tuxedotshirt/Hydroponic_System/Marketing/Stackable Tower v18 (1).gif

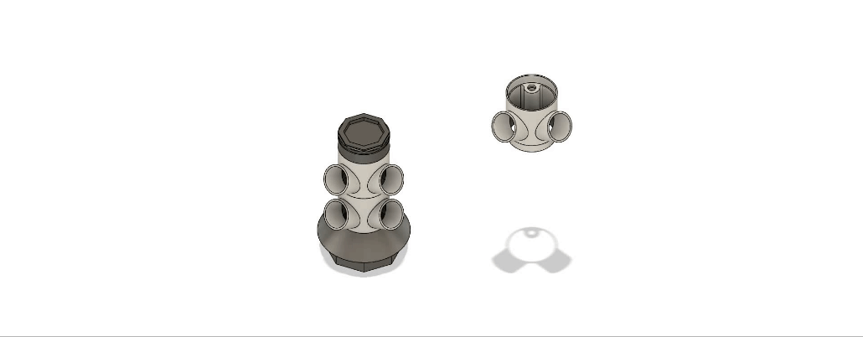
Marketing/Stackable Tower v18 (1).gif
