tuxedotshirt/Hydroponic_System/Marketing/Stackable Tower v18.gif

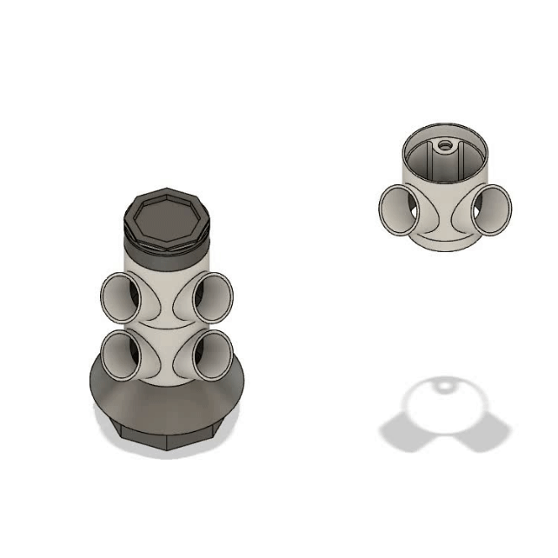
Marketing/Stackable Tower v18.gif
