tuxedotshirt/Hydroponic_System/Peristaltic Pump/Carrier.obj

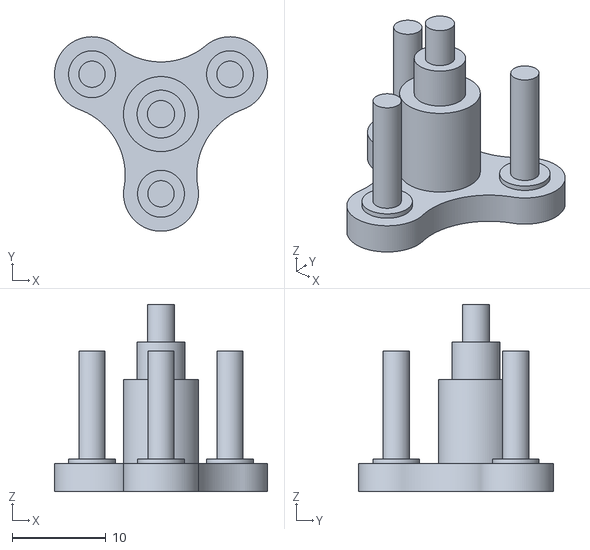
[picture p3: CAD file, 2023-01-23]
Peristaltic Pump/Carrier.obj
22.7 x 20.7 x 20.0
