tuxedotshirt/Hydroponic_System/Peristaltic Pump/Planetary Peristaltic Pump/Carrier.obj

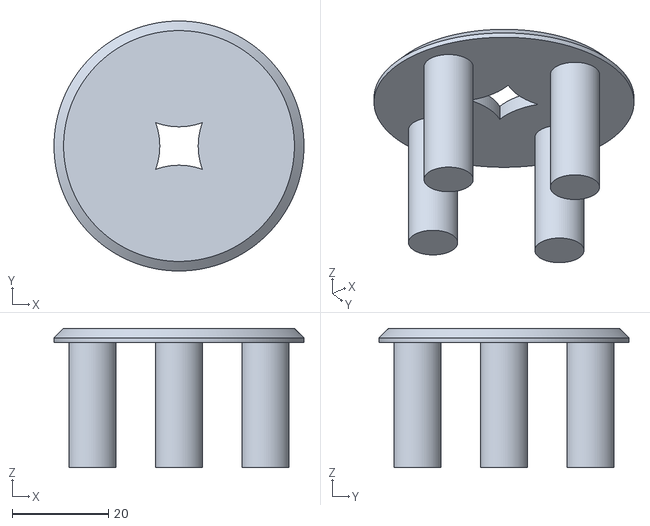
[picture p4: CAD file, 2023-04-20]
Peristaltic Pump/Planetary Peristaltic Pump/Carrier.obj
52.0 x 52.0 x 29.0
