tuxedotshirt/Hydroponic_System/Stackable Tower/Spacer.obj

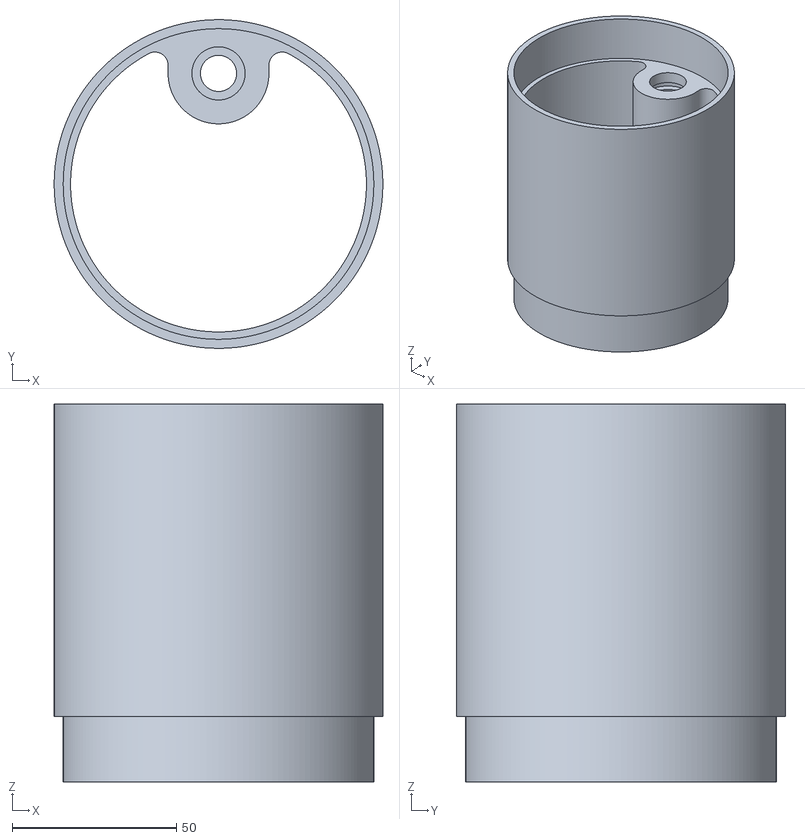
[picture p5: CAD file, 2023-11-28]
Stackable Tower/Spacer.obj
100.0 x 100.0 x 115.0
