tuxedotshirt/Hydroponic_System/Peristaltic Pump/Planetary Peristaltic Pump/Sun - 0.2mm Backlash (14 teeth).obj

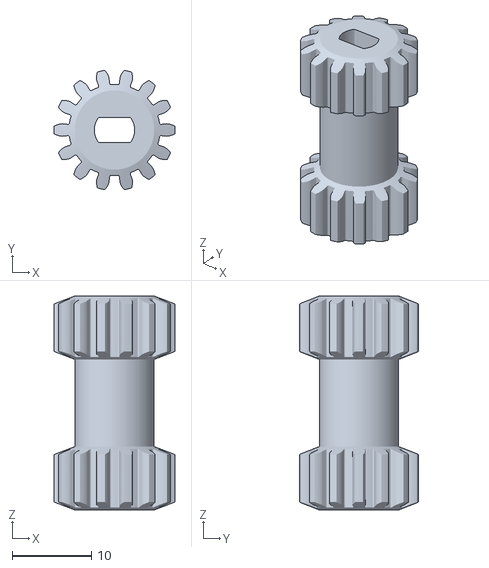
[picture p6: CAD file, 2023-04-20]
Peristaltic Pump/Planetary Peristaltic Pump/Sun - 0.2mm Backlash (14 teeth).obj
15.2 x 15.1 x 27.0
