tuxedotshirt/Hydroponic_System/Peristaltic Pump/Pump Body Cap.obj

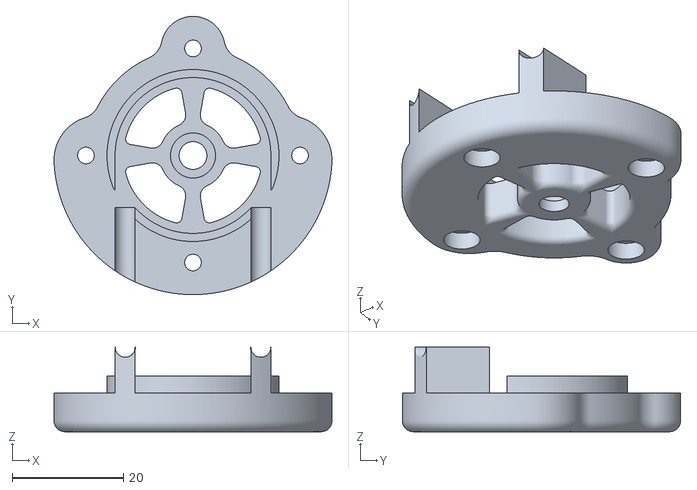
[picture p7: CAD file, 2023-01-23]
Peristaltic Pump/Pump Body Cap.obj
50.0 x 50.0 x 15.2
