tuxedotshirt/Hydroponic_System/Peristaltic Pump/Carrier Cap.obj

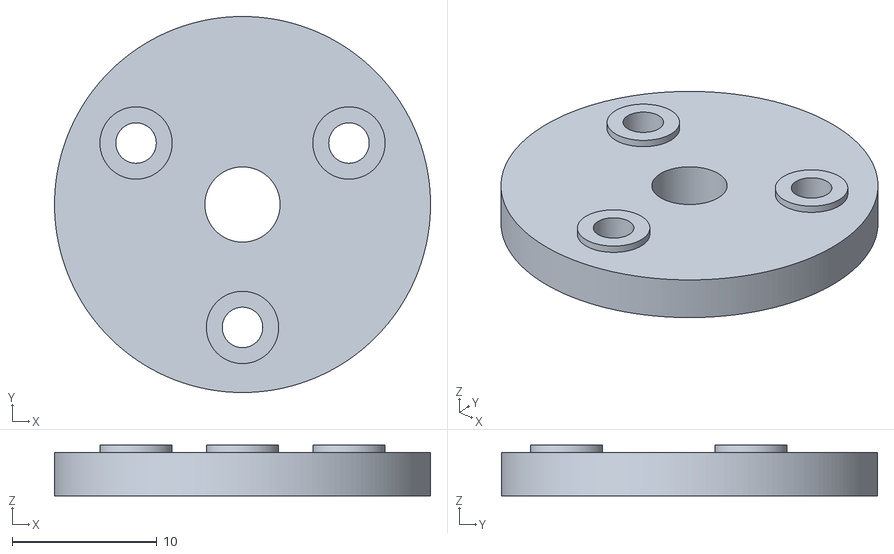
[picture p8: CAD file, 2023-01-23]
Peristaltic Pump/Carrier Cap.obj
26.0 x 26.0 x 3.50
