tuxedotshirt/Hydroponic_System/Peristaltic Pump/Planetary Peristaltic Pump/Sun.obj

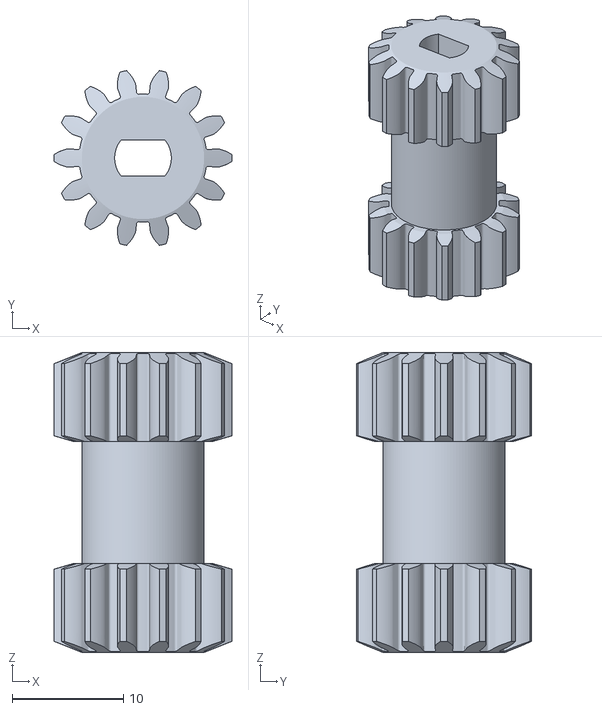
[picture p9: CAD file, 2023-04-20]
Peristaltic Pump/Planetary Peristaltic Pump/Sun.obj
16.0 x 15.7 x 27.0
