tuxedotshirt/Hydroponic_System/Peristaltic Pump/Planetary Peristaltic Pump/Planet.obj

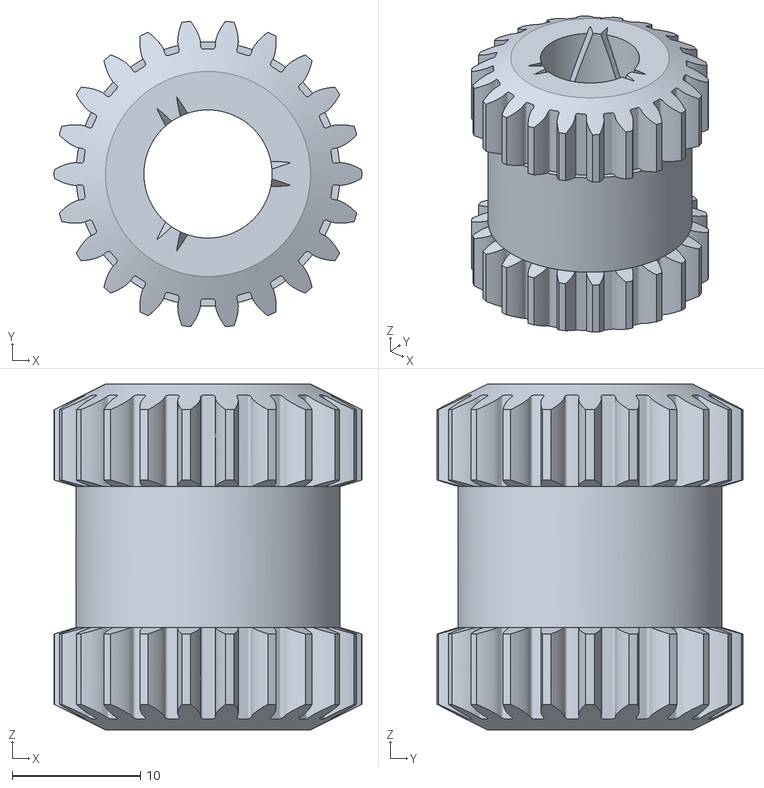
[picture p10: CAD file, 2023-04-20]
Peristaltic Pump/Planetary Peristaltic Pump/Planet.obj
24.0 x 23.8 x 27.0
