tuxedotshirt/Hydroponic_System/Stackable Tower/Base.obj

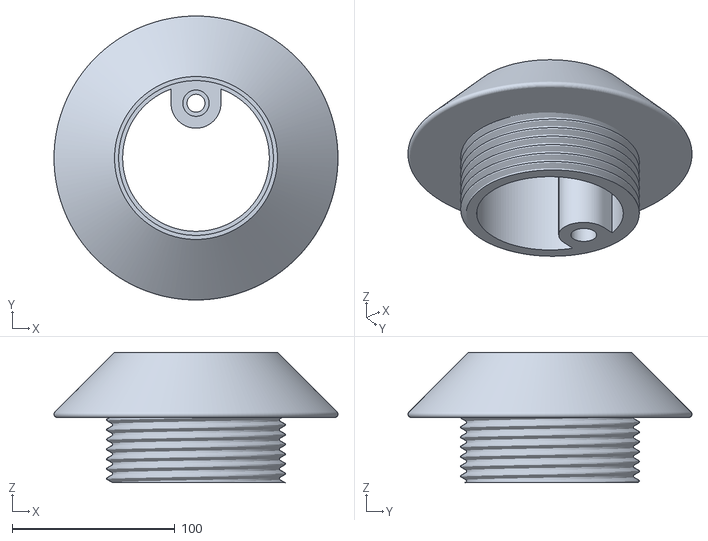
[picture p11: CAD file, 2023-11-12]
Stackable Tower/Base.obj
174.3 x 174.3 x 80.0
