tuxedotshirt/Hydroponic_System/Peristaltic Pump/Planetary Peristaltic Pump/RingTop.obj

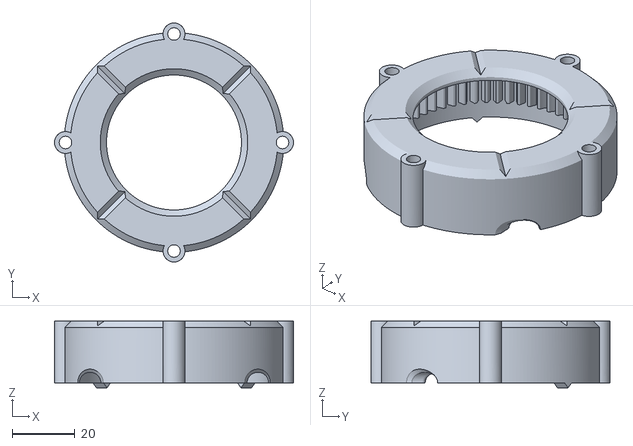
[picture p12: CAD file, 2023-04-20]
Peristaltic Pump/Planetary Peristaltic Pump/RingTop.obj
76.2 x 76.2 x 21.2
