tuxedotshirt/Hydroponic_System/Stackable Tower/Middle Module.obj

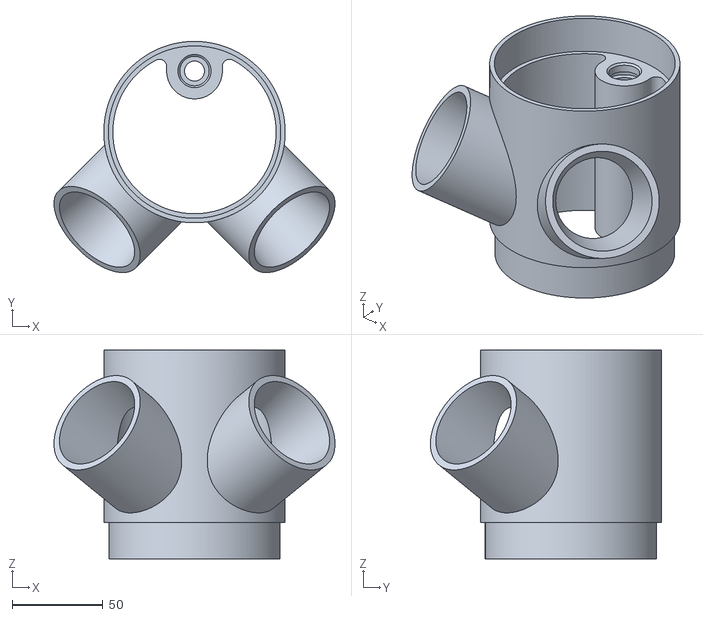
[picture p13: CAD file, 2023-11-12]
Stackable Tower/Middle Module.obj
154.9 x 127.5 x 115.0
