tuxedotshirt/Hydroponic_System/Stackable Tower/Shower Top Base.obj

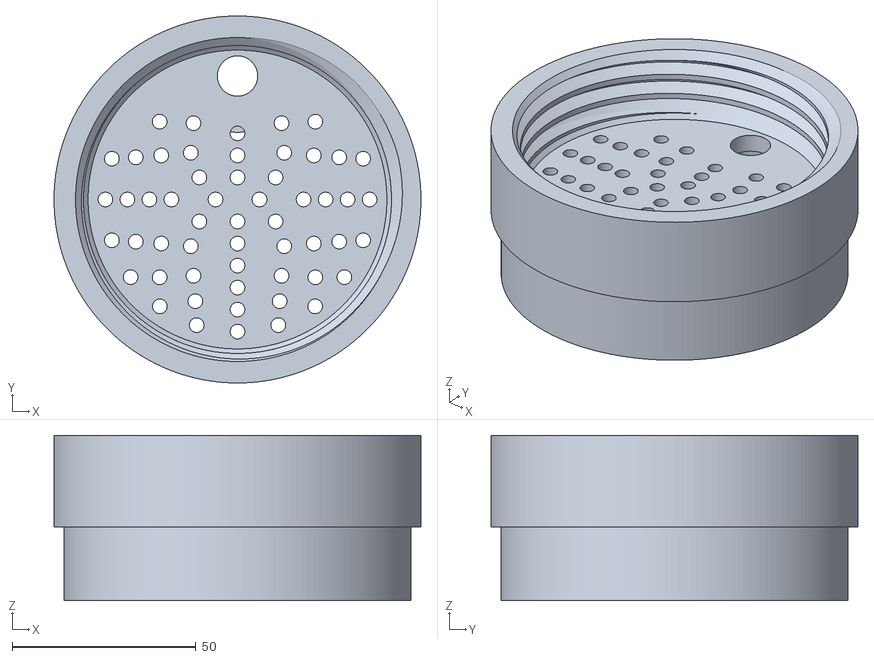
[picture p14: CAD file, 2023-11-12]
Stackable Tower/Shower Top Base.obj
100.0 x 100.0 x 45.0
