tuxedotshirt/Hydroponic_System/Stackable Tower/Screw Top.obj

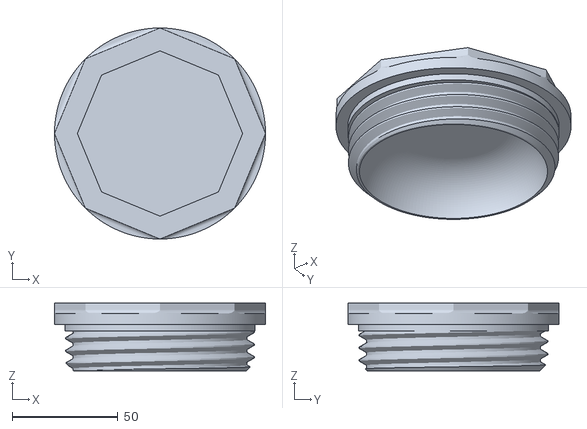
[picture p15: CAD file, 2023-11-12]
Stackable Tower/Screw Top.obj
100.0 x 100.0 x 32.2
