tuxedotshirt/Hydroponic_System/Stackable Tower/Nut.obj

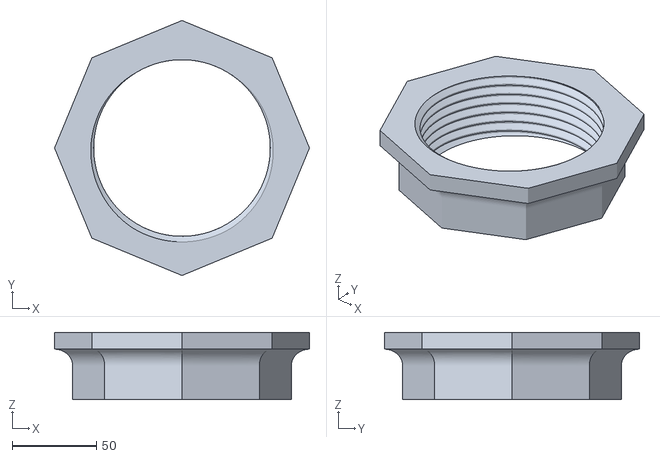
[picture p16: CAD file, 2023-11-12]
Stackable Tower/Nut.obj
151.5 x 151.5 x 40.0
