tuxedotshirt/Hydroponic_System/Hydro Documents/pH Probe/EZO-carrier-board-non-isolated.pdf

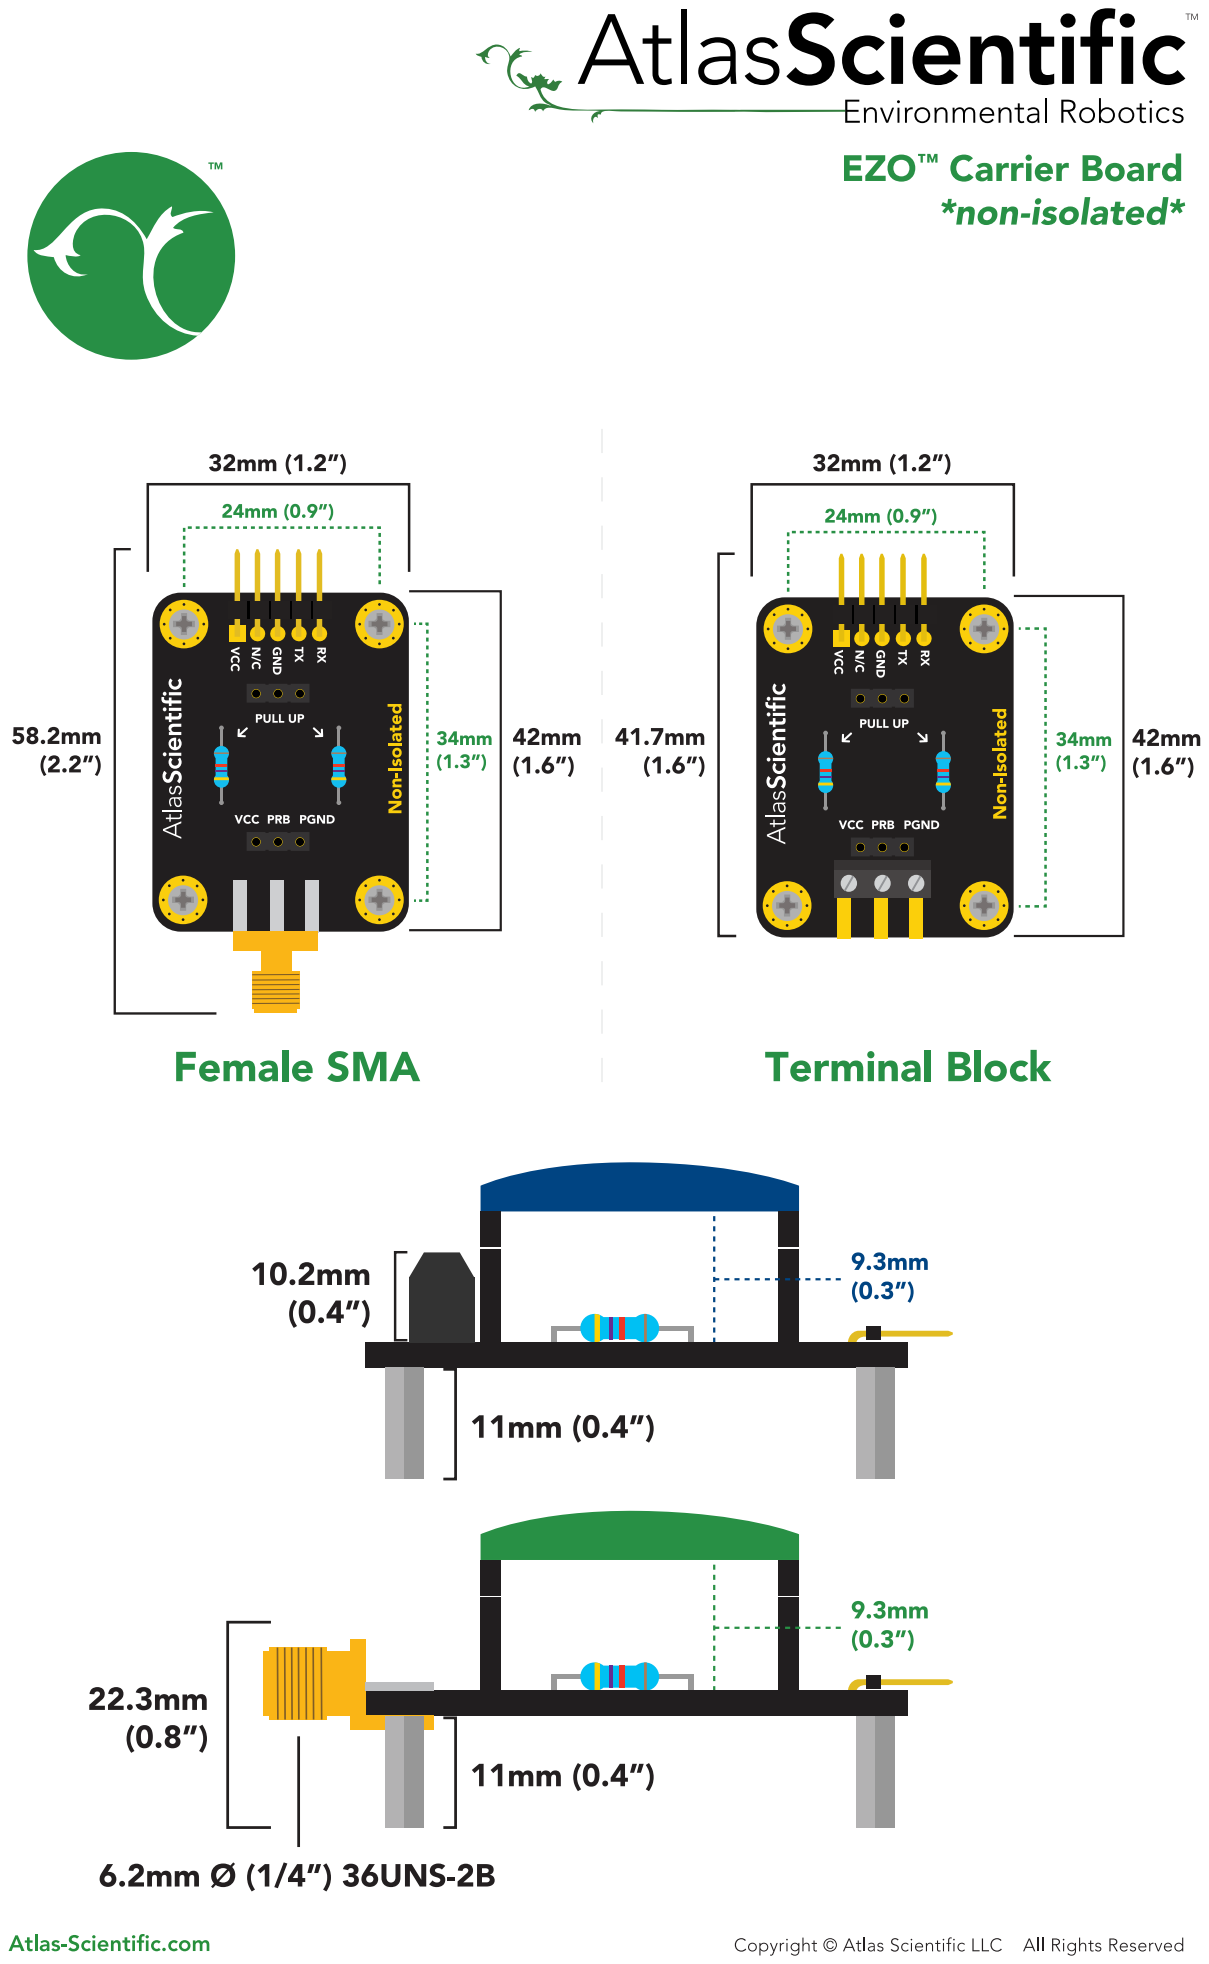
[picture p17: page 1]

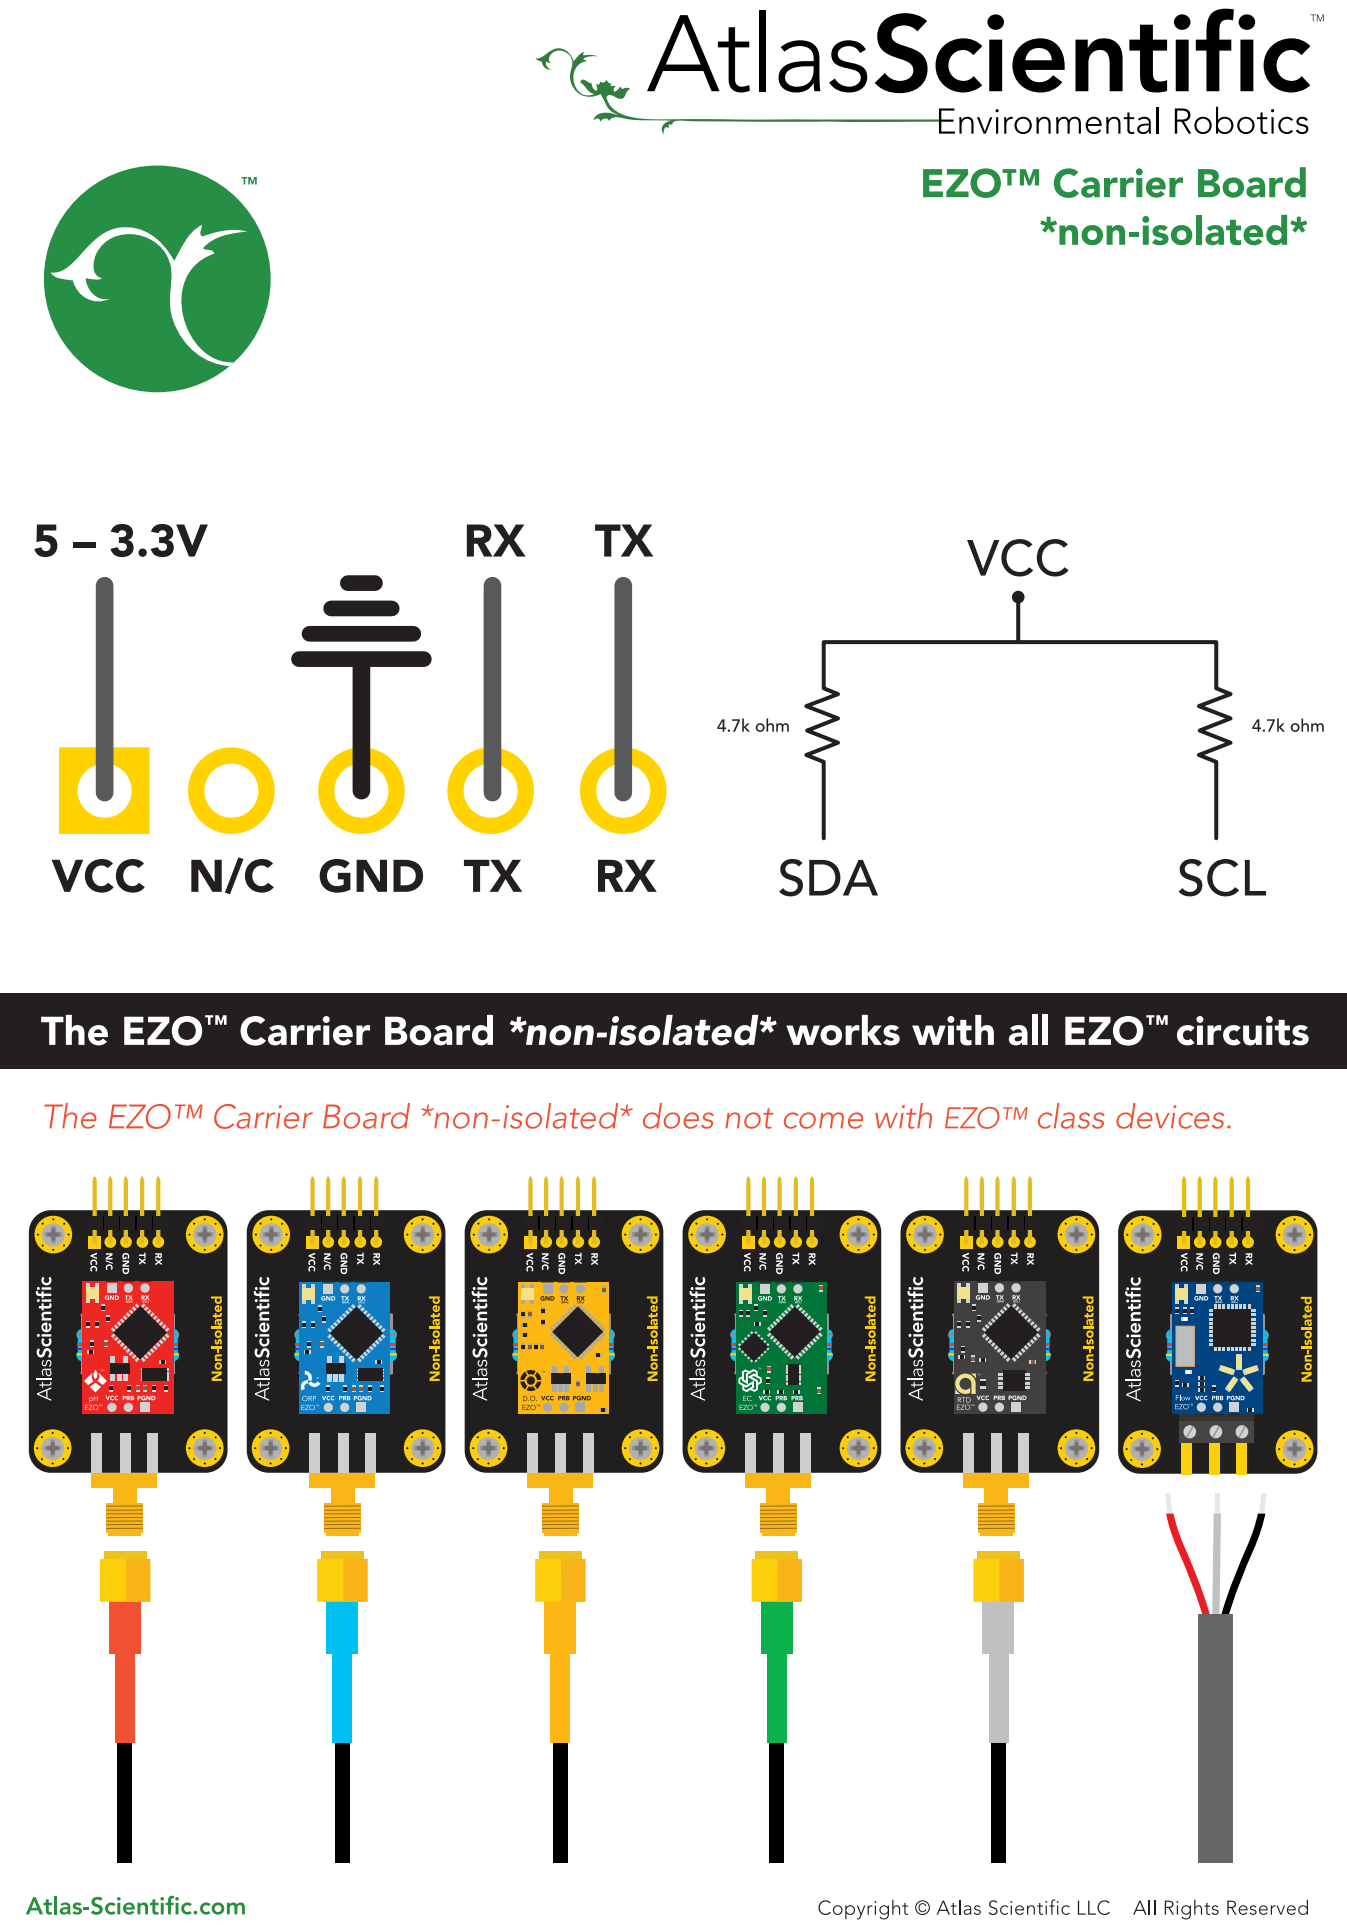
[picture p18: page 2]
