tuxedotshirt/Hydroponic_System/Hydro Documents/TDS Meter/plant_watering-V2.pdf

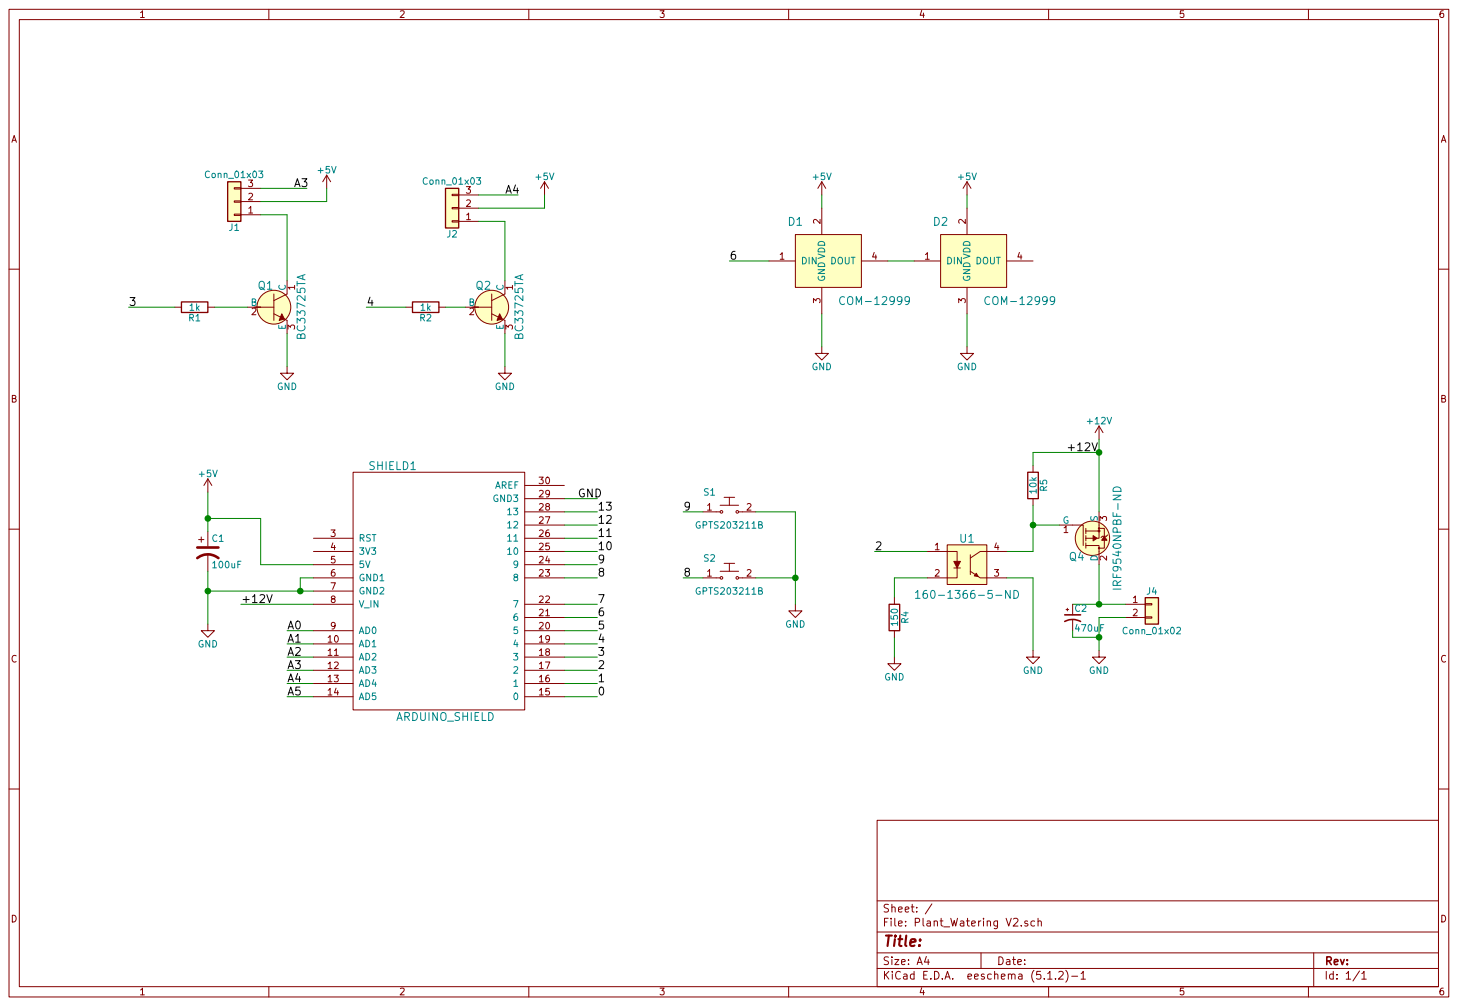
[picture p19: page 1]

3 DOUT 4 D1 COM-12999 DIN 1 VDD
