tuxedotshirt/Hydroponic_System/PCBs/Photo Light/Supplemental Light/Supplemental Light.kicad_pcb

## KiCad design PCBs/Photo Light/Supplemental Light/Supplemental Light.kicad_pcb (2023-12-05)

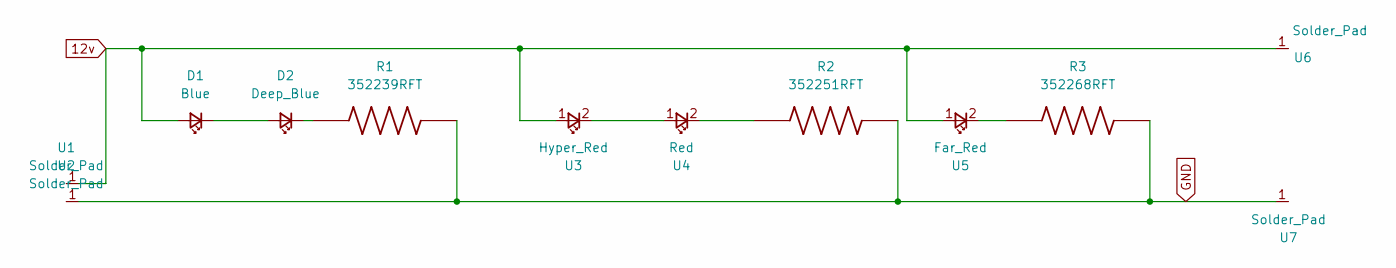
[picture p20: schematic Supplemental Light.kicad_sch]

Parts:
D1: Blue
D2: Deep_Blue; Deep Blue
R1: 352239RFT; RESC6332X120N
R2: 352251RFT; RESC6332X120N
R3: 352268RFT; RESC6332X120N
U1, U2, U6, U7: Solder_Pad; Solder Pad
U3: Hyper_Red; Hyper Red
U4: Red
U5: Far_Red; Far Red

Connections:
12v: D1.1 (A), U1.1, U3.1, U5.1, U6.1
GND: R1.2, R2.2, R3.2, U2.1, U7.1
unnamed: D1.2 (K), D2.1 (A)
unnamed: D2.2 (K), R1.1
unnamed: R2.1, U4.2
unnamed: U3.2, U4.1
unnamed: R3.1, U5.2

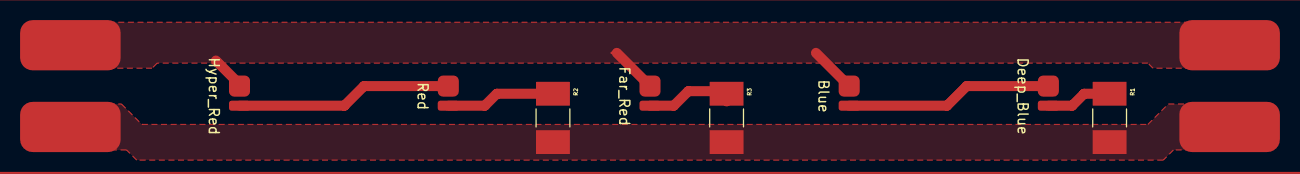
[picture p21: board Supplemental Light.kicad_pcb from above]

Board: 2 copper layers, 12 parts (0 on the bottom side), 7 nets.
