tuxedotshirt/Hydroponic_System/PCBs/Lights/HydroLights.kicad_pcb

## KiCad design PCBs/Lights/HydroLights.kicad_pcb (2023-05-21)

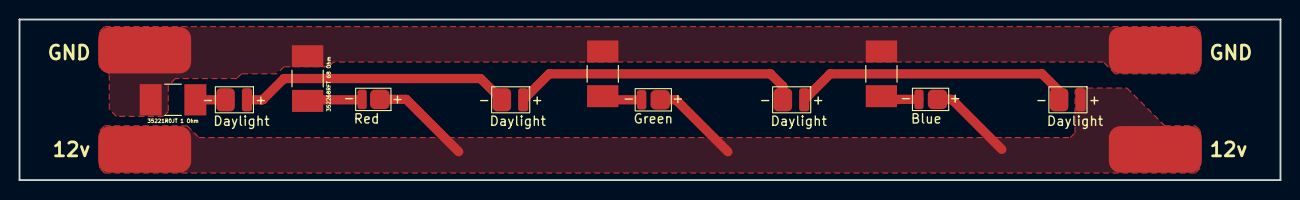
[picture p22: board HydroLights.kicad_pcb from above]

Board: 2 copper layers, 135.6 x 17.3 mm, 15 parts (0 on the bottom side), 9 nets.

Parts:
R1: 352268RFT 68 Ohm; RESC6332X120N
R2, R4: 352262RFT 62 Ohm; RESC6332X120N
R3: 35221R0JT 1 Ohm; RESC6332X120N
U1, U2, U10, U11: Solder_Pad; Solder Pad
U3, U5, U7, U9: Daylight; 158303250A(Daylight)
U4: Red; 150283HS73103(Red)
U6: Blue; 150283BS73103(Blue)
U8: Green; 150283BS73103(Green)

Connections:
12v: U1.1, U3.2, U4.1, U6.1, U8.1, U10.1
GND: R1.2, R2.2, R3.1, R4.2, U2.1, U11.1
unnamed: R1.1, U4.2
unnamed: R2.1, U6.2
unnamed: R3.2, U9.1
unnamed: R4.1, U8.2
unnamed: U3.1, U5.2
unnamed: U5.1, U7.2
unnamed: U7.1, U9.2
