tuxedotshirt/Hydroponic_System/PCBs/Main Board/Hydro.kicad_pcb

## KiCad design PCBs/Main Board/Hydro.kicad_pcb (2023-05-09)

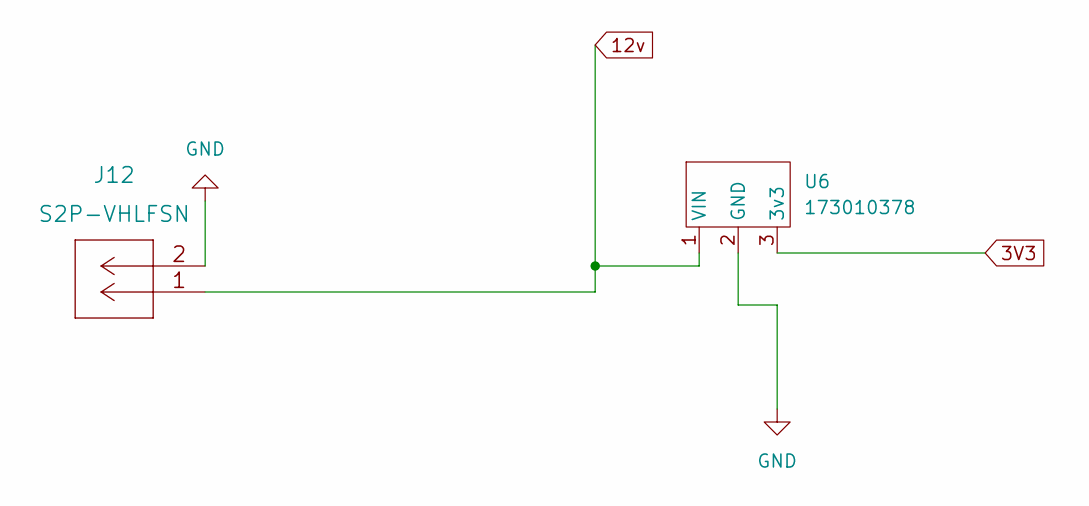
[picture p23: schematic PowerSupply.kicad_sch]

Parts:
J12: S2P-VHLFSN
U6: 173010378

Connections:
3V3: U6.3 (3v3); also elsewhere on the board
12v: J12.1, U6.1 (VIN); also elsewhere on the board
GND: J12.2, U6.2 (GND); also elsewhere on the board

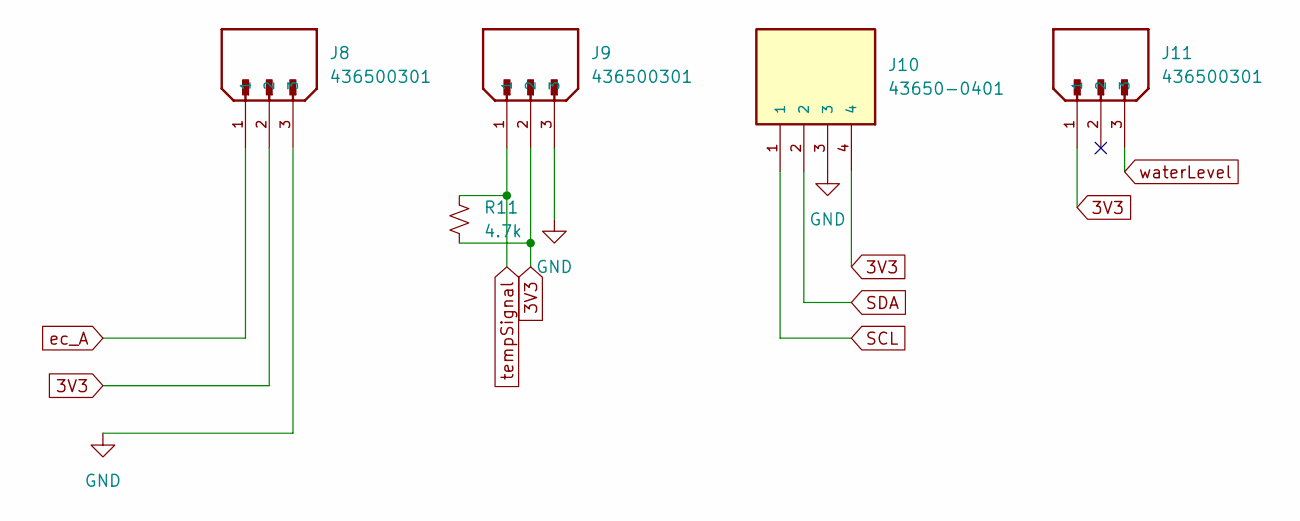
[picture p24: schematic Sensors.kicad_sch]

Parts:
J8, J9, J11: 436500301; MOLEX_436500301; PARTREV D7
J10: 43650-0401; MOLEX_43650-0401; PARTREV D7
R11: 4.7k; R_Axial_DIN0204_L3.6mm_D1.6mm_P7.62mm_Horizontal

Connections:
3V3: J8.2, J9.2, J10.4, J11.1, R11.2; also elsewhere on the board
GND: J8.3, J9.3, J10.3; also elsewhere on the board
SCL: J10.1; also elsewhere on the board
SDA: J10.2; also elsewhere on the board
ec_A: J8.1; also elsewhere on the board
tempSignal: J9.1, R11.1; also elsewhere on the board
waterLevel: J11.3; also elsewhere on the board

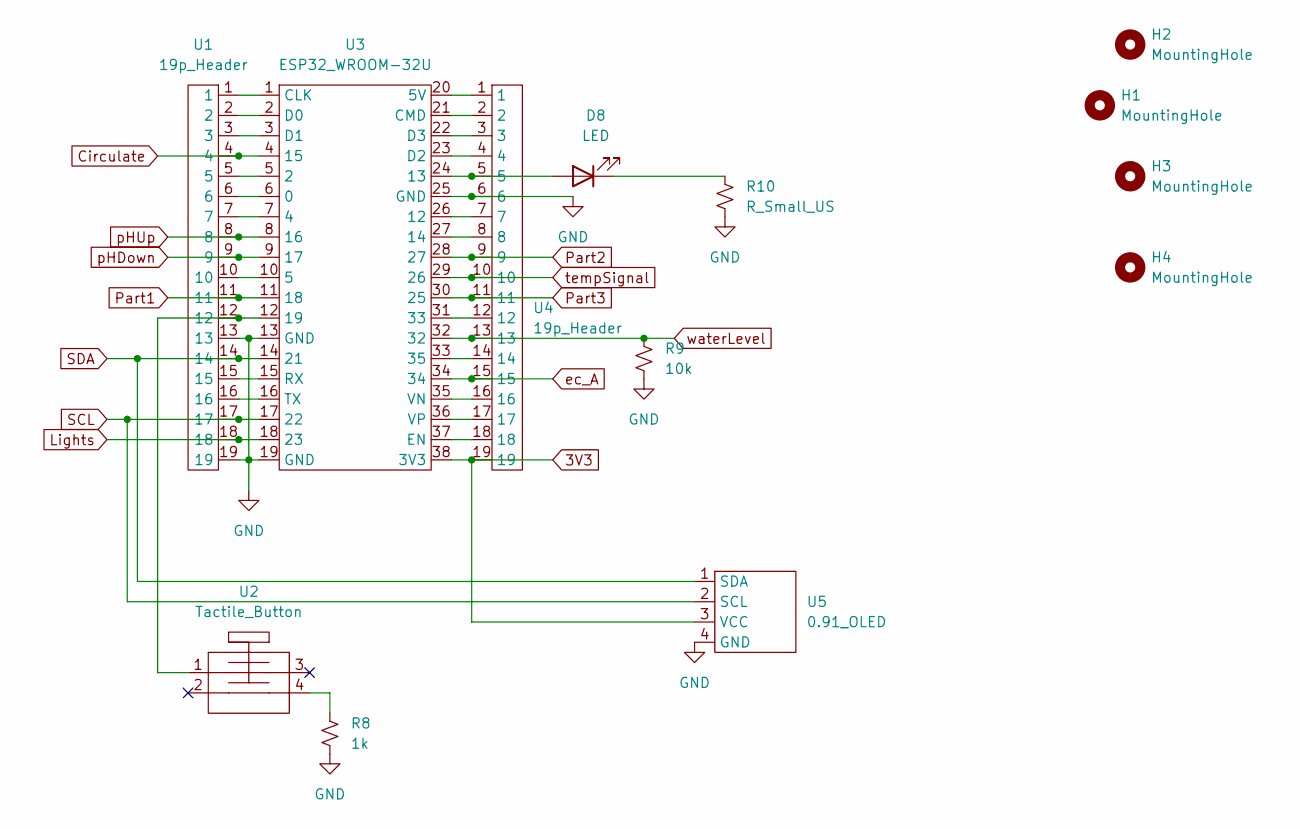
[picture p25: schematic ESP32.kicad_sch]

Parts:
D8: LED; LED_D5.0mm
H1, H2, H3, H4: MountingHole; Mounting Hole
R8: 1k; R_Axial_DIN0204_L3.6mm_D1.6mm_P7.62mm_Horizontal
R9: 10k; R_Axial_DIN0204_L3.6mm_D1.6mm_P7.62mm_Horizontal
R10: R_Small_US; R_Axial_DIN0204_L3.6mm_D1.6mm_P7.62mm_Horizontal
U1, U4: 19p_Header; 19p Header
U2: Tactile_Button
U3: ESP32_WROOM-32U; ESP32-WROOM-32U
U5: 0.91_OLED; 0.91 OLED

Connections:
3V3: U3.38 (3V3), U4.19, U5.3 (VCC); also elsewhere on the board
Circulate: U1.4, U3.4 (15); also elsewhere on the board
GND: R8.2, R9.2, R10.2, U1.13, U1.19, U3.13 (GND), U3.19 (GND), U3.25 (GND), U4.6, U5.4 (GND); also elsewhere on the board
Lights: U1.18, U3.18 (23); also elsewhere on the board
unnamed: D8.1 (K), R10.1
unnamed: D8.2 (A), U3.24 (13), U4.5
unnamed: R8.1, U2.4
unnamed: U1.1, U3.1 (CLK)
unnamed: U1.2, U3.2 (D0)
unnamed: U1.3, U3.3 (D1)
unnamed: U1.5, U3.5 (2)
unnamed: U1.6, U3.6 (0)
unnamed: U1.7, U3.7 (4)
unnamed: U1.10, U3.10 (5)
unnamed: U1.12, U2.1, U3.12 (19)
unnamed: U1.15, U3.15 (RX)
unnamed: U1.16, U3.16 (TX)
unnamed: U3.20 (5V), U4.1
unnamed: U3.21 (CMD), U4.2
unnamed: U3.22 (D3), U4.3
unnamed: U3.23 (D2), U4.4
unnamed: U3.26 (12), U4.7
unnamed: U3.27 (14), U4.8
unnamed: U3.31 (33), U4.12
unnamed: U3.33 (35), U4.14
unnamed: U3.35 (VN), U4.16
unnamed: U3.36 (VP), U4.17
unnamed: U3.37 (EN), U4.18
Part1: U1.11, U3.11 (18); also elsewhere on the board
Part2: U3.28 (27), U4.9; also elsewhere on the board
Part3: U3.30 (25), U4.11; also elsewhere on the board
SCL: U1.17, U3.17 (22), U5.2 (SCL); also elsewhere on the board
SDA: U1.14, U3.14 (21), U5.1 (SDA); also elsewhere on the board
ec_A: U3.34, U4.15; also elsewhere on the board
pHDown: U1.9, U3.9 (17); also elsewhere on the board
pHUp: U1.8, U3.8 (16); also elsewhere on the board
tempSignal: U3.29 (26), U4.10; also elsewhere on the board
waterLevel: R9.1, U3.32, U4.13; also elsewhere on the board

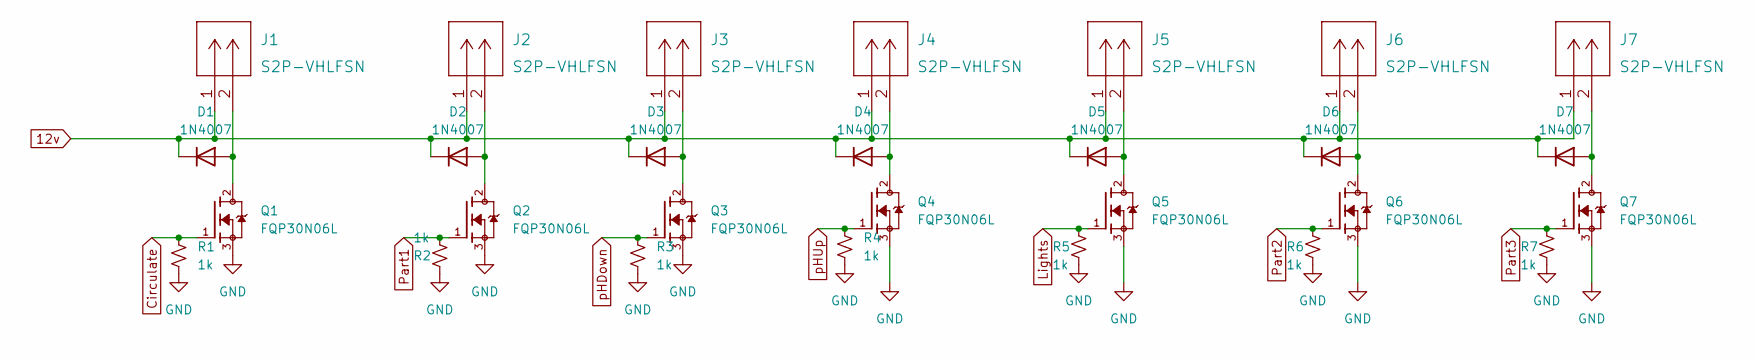
[picture p26: schematic MOSFETs.kicad_sch]

Parts:
D1, D2, D3, D4, D5, D6, D7: 1N4007; D_DO-41_SOD81_P10.16mm_Horizontal
J1, J2, J3, J4, J5, J6, J7: S2P-VHLFSN
Q1, Q2, Q3, Q4, Q5, Q6, Q7: FQP30N06L; TO220V
R1, R2, R3, R4, R5, R6, R7: 1k; R_Axial_DIN0207_L6.3mm_D2.5mm_P7.62mm_Horizontal

Connections:
12v: D1.1 (K), D2.1 (K), D3.1 (K), D4.1 (K), D5.1 (K), D6.1 (K), D7.1 (K), J1.1, J2.1, J3.1, J4.1, J5.1, J6.1, J7.1; also elsewhere on the board
Circulate: Q1.1, R1.1; also elsewhere on the board
GND: Q1.3, Q2.3, Q3.3, Q4.3, Q5.3, Q6.3, Q7.3, R1.2, R2.2, R3.2, R4.2, R5.2, R6.2, R7.2; also elsewhere on the board
Lights: Q5.1, R5.1; also elsewhere on the board
unnamed: D1.2 (A), J1.2, Q1.2
unnamed: D2.2 (A), J2.2, Q2.2
unnamed: D3.2 (A), J3.2, Q3.2
unnamed: D4.2 (A), J4.2, Q4.2
unnamed: D5.2 (A), J5.2, Q5.2
unnamed: D6.2 (A), J6.2, Q6.2
unnamed: D7.2 (A), J7.2, Q7.2
Part1: Q2.1, R2.1; also elsewhere on the board
Part2: Q6.1, R6.1; also elsewhere on the board
Part3: Q7.1, R7.1; also elsewhere on the board
pHDown: Q3.1, R3.1; also elsewhere on the board
pHUp: Q4.1, R4.1; also elsewhere on the board

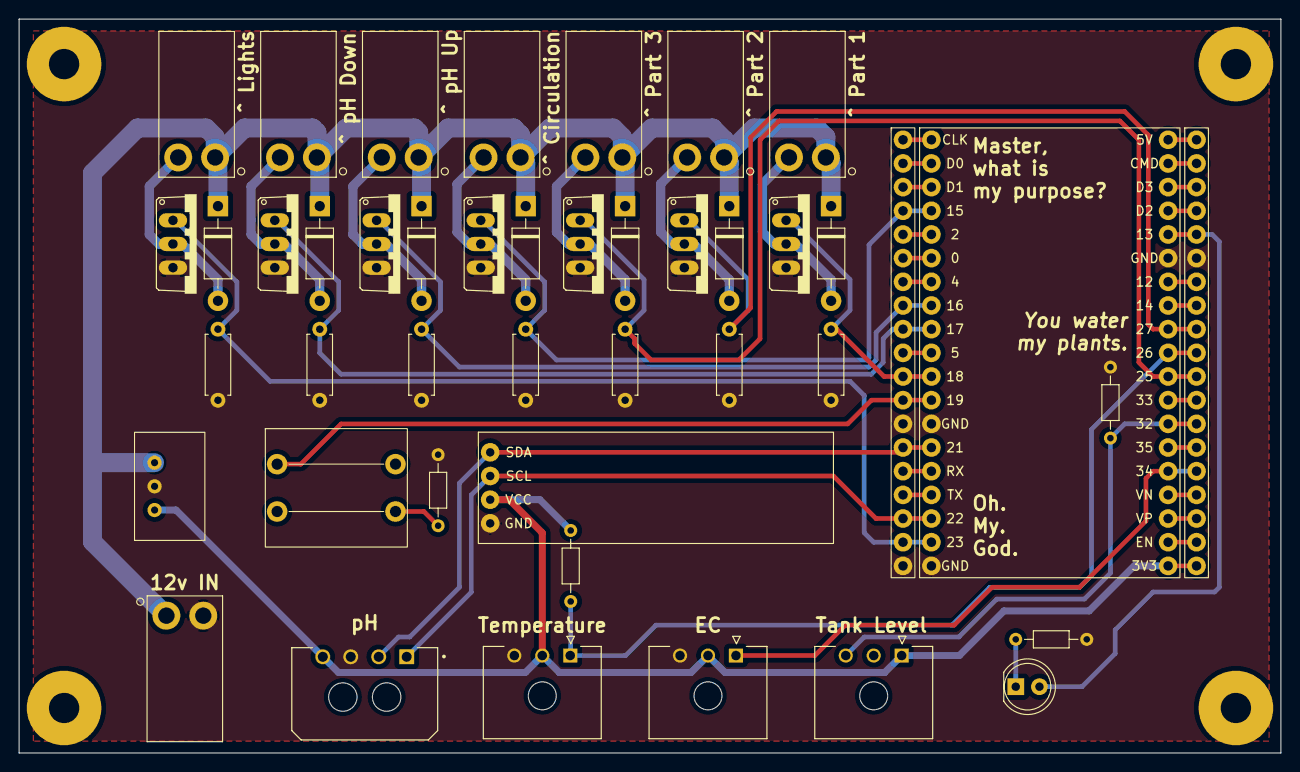
[picture p27: board Hydro.kicad_pcb from above]

Board: 2 copper layers, 135.4 x 78.7 mm, 48 parts (0 on the bottom side), 46 nets.
