tuxedotshirt/Hydroponic_System/hydro_esp32_1/pinDefinitions.h

//Pin definitions

#define circulation 15
#define pHUp 16
#define pHDown 17
#define part1 18
#define lights 23
#define part2 27
#define part3 25
#define errorLED 13
#define SW 19
#define waterLevel 32

#define TdsSensorPin 34
#define oneWireBus 26
