tuxedotshirt/Hydroponic_System/hydro_esp32_1/OLED.ino

void writeMessage(String message) {
  display.clearDisplay();

  display.setTextSize(1);             // Normal 1:1 pixel scale
  display.setTextColor(SSD1306_WHITE);        // Draw white text
  display.setCursor(0, 0);            // Start at top-left corner
  display.println(message);
  display.display();
  delay(500);
}
