tuxedotshirt/Hydroponic_System/hydro_esp32_1/TODO.ino

/*TODO:
    send reset request over ble for factory settings
    Save deploymentID for DB from app to construct the URL string
    Add nutrient ratios to app
    Add manual nutrient ratio
    Add light on/off times to app
    Add manual time entry and tz compensation to app
    ecPref, phPref, kvalue, p1, p2 and p3 mutex to make sure the global isn't being accessed at the same time.
    check pH reading validity before calling pumps.
*/
