tuxedotshirt/Hydroponic_System/hydro_esp32_1/preferenceDefinitions.h

#define pwdPref "pwd"
#define ecPref "ecSetting"
#define pHPref "pHSetting"
#define bleNamePref "bleNameSetting"
#define ssidPref "ssidPref"
#define kValue "kValue"
#define lightOn "lightOn"
#define lightOff "lightOff"
#define p1 "p1"
#define p2 "p2"
#define p3 "p3"
#define ecCalibrateTemp "ecTemperature"
//#define yIntercept "yIntercept"
//#define slope "slope"
