tuxedotshirt/Hydroponic_System/(commit log)

2023-01-01 Add wifi and DB
    [MotorDriver.kicad_sch, ezo_ph_circuit.kicad_sch]
2023-01-23 Fix WIFI and BLE bug
    [Carrier Cap.obj, Carrier.obj, Pump Body Cap.obj]
2023-01-23 Add BLE indicator LED
2023-04-08 PCB Update
    [3v3Regulator.kicad_sch, 5v_Regulator.kicad_sch, ESP32.kicad_sch, Hydro.kicad_pcb, Hydro.kicad_sch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]
2023-04-17 Remove steppers, add OLED
    [ESP32.kicad_sch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]
2023-04-17 update pcb
    [Hydro.kicad_pcb]
2023-04-20 Finished PCBs
    [Carrier.obj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]
2023-04-27 Changed some pins
    [ESP32.kicad_sch, Hydro.kicad_pcb, Hydro.kicad_sch, MOSFETs.kicad_sch, PowerSupply.kicad_sch, Sensors.kicad_sch]
2023-04-29 Error LED code update
    [Hydro-B_Cu.gbr, Hydro-B_Mask.gbr, Hydro-B_Silkscreen.gbr, Hydro-Edge_Cuts.gbr, Hydro-F_Cu.gbr, Hydro-F_Mask.gbr, Hydro-F_Silkscreen.gbr, Hydro-NPTH.drl]
2023-05-04 changed semaphore wait to ms
    [ESP32.kicad_sch, Hydro.kicad_pcb, Hydro.kicad_sch, PowerSupply.kicad_sch, Sensors.kicad_sch]
2023-05-09 Changes to PCB, wired sensors to board
    [ESP32.kicad_sch, Hydro.kicad_pcb, Hydro.kicad_sch, Sensors.kicad_sch]
2023-05-16 Finished EC and pH probe calibration
2023-05-21 PCB changes
    [HydroLights.kicad_pcb]
2023-07-16 Document Cleanup
    [ph-layout.dxf]
2023-07-18 Arduino IDE branch test
2023-11-12 Testing pH probe errors
    [Base.obj, Middle Module.obj, Nut.obj, Screw Top.obj, Shower Top Base.obj]
2023-11-15 Fix pH probe calibration to work with I2C
    No examples or datasheet for I2C communication besides taking a reading. Figured it out. Fixed electrical interference with pH probe.
    [defaultValues.h, hydro_esp32_1.ino, preferenceDefinitions.h]
2023-11-28 Add printable assets
    [Spacer.obj]
2023-12-05 New lights
    [Supplemental Light.kicad_pcb, Supplemental Light.kicad_sch]
